Yevgeniy-Olexandrenko/avr-ay-board/hardware/README.md

PCB v1.4|PCB v1.5
:-:|:-:
|
|
New schematic and PCB design, Moved J1 closer to J2|Power LED, alternative ICSP on PSG pins
