Yevgeniy-Olexandrenko/avr-ay-board/hardware/v1.5/AY-3-8912-Emulator-v1.5_BOM.tsv

ID | Name | Designator | Footprint | Quantity | Manufacturer Part | Manufacturer | Supplier | Supplier Part
1 | 18p | C1,C3 | C0603 | 2 | CL10C180JB8NNNC | SAMSUNG | LCSC | C1647
2 | 100n | C2,C4 | C0603 | 2 | CC0603KRX7R9BB104 | YAGEO | LCSC | C14663
3 | 2.2n | C5,C6,C7 | C0603 | 3 | 0603B222K500NT | FH | LCSC | C1604
4 | 27MHz | X1 | OSC-SMD_4P-L3.2-W2.5-BL | 1 | X3S027000BA1H-U | HELE(台湾加高) | LCSC | C136079
5 | 1.4k | R4 | R0603 | 1 | CQ03WAF1401T5E | UNI-ROYAL(厚声) | LCSC | C2759756
6 | POWER | LED1 | LED0603_BLUE | 1 | FYLS-0603UBC | FORYARD
7 | ATMEGA48PA-AU | MCU | TQFP-32_L7.0-W7.0-P0.80-LS9.0-BL | 1 | ATMEGA88PA-AU | MICROCHIP(美国微芯) | LCSC | C8727
8 | 3.6k | R1,R2,R3 | R0603 | 3 | 0603WAF3601T5E | UNI-ROYAL(厚声) | LCSC | C22980
