Yevgeniy-Olexandrenko/avr-ay-board/hardware/v1.5/AY-3-8912-Emulator-v1.5_Schematic.pdf

# Headers

# Low-pass filters

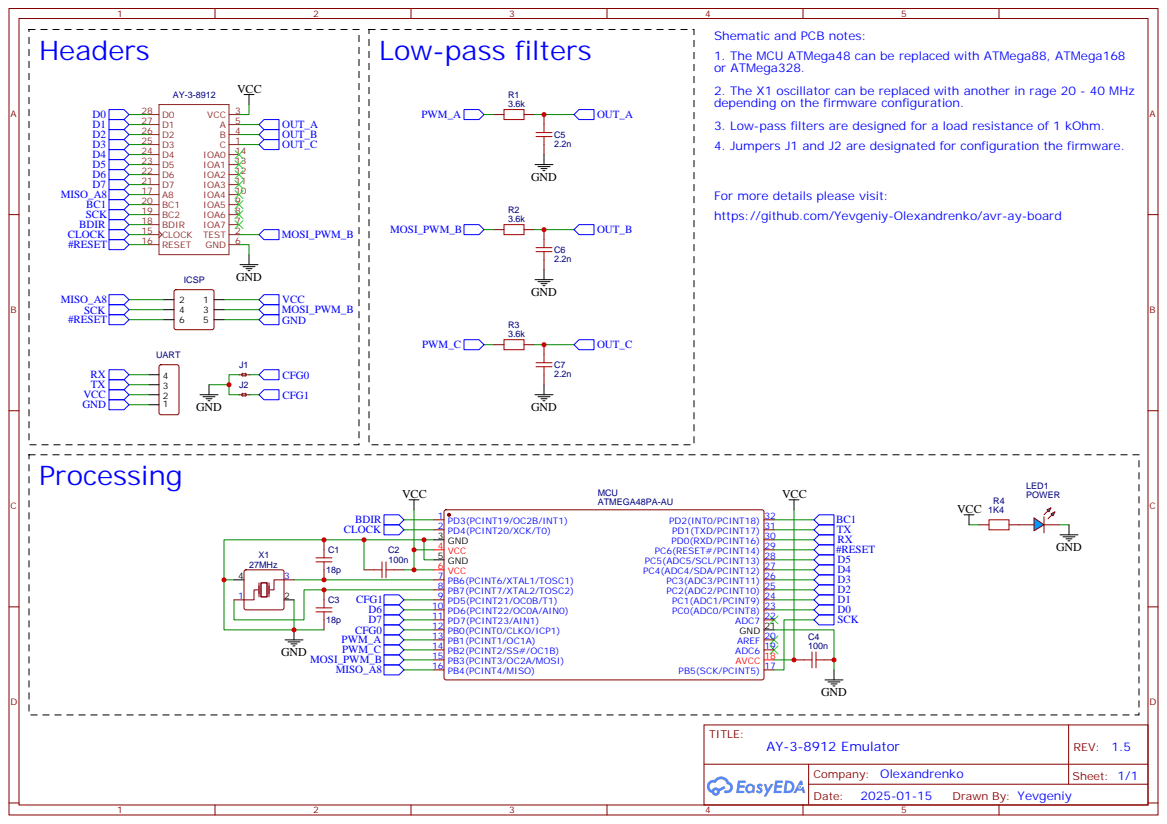
[picture p2: page 1]

Shematic and PCB notes:
1. The MCU ATMega48 can be replaced with ATMega88, ATMega168
or ATMega328.
2. The X1 oscillator can be replaced with another in rage 20 - 40 MHz
depending on the firmware configuration.
3. Low-pass filters are designed for a load resistance of 1 kOhm.
4. Jumpers J1 and J2 are designated for configuration the firmware.

For more details please visit:
https://github.com/Yevgeniy-Olexandrenko/avr-ay-board
