Yevgeniy-Olexandrenko/avr-ay-board/hardware/v1.2/AY-3-8912-Emulator-v1.2_Schematic.pdf

Processing | Low-pass filters

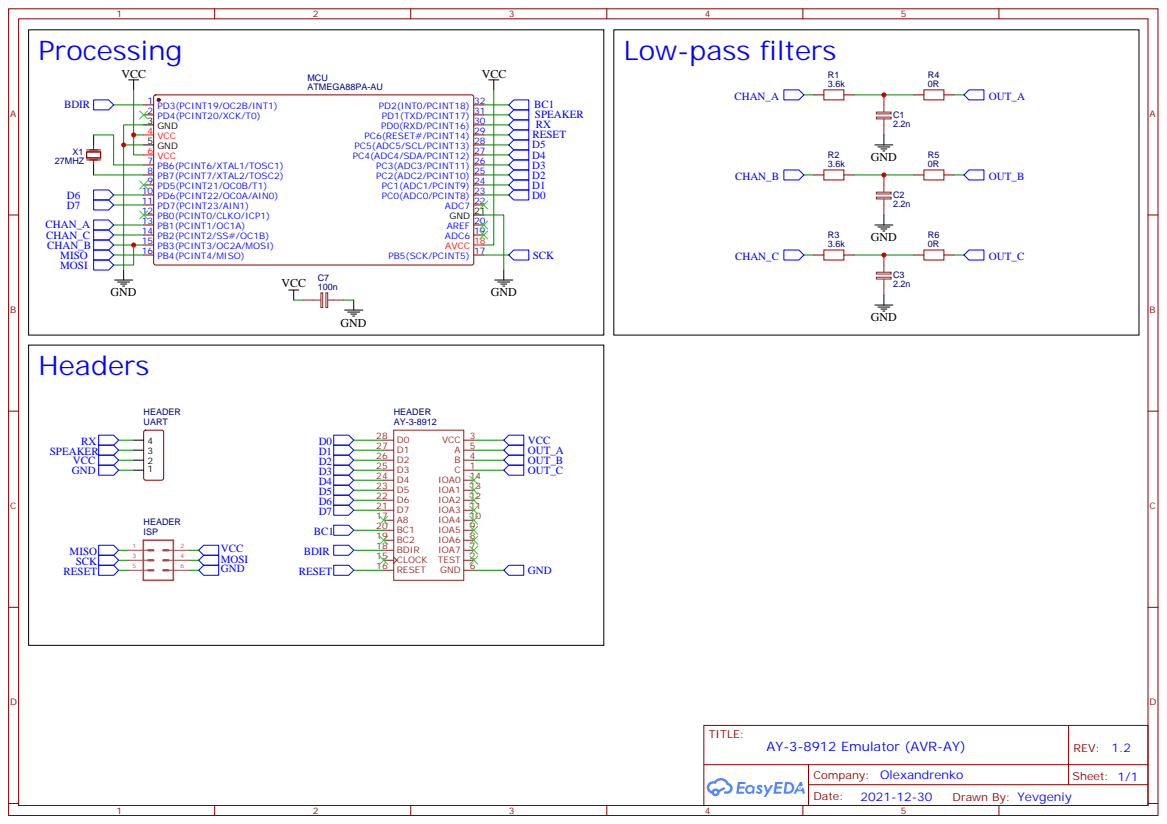
[picture p3: page 1]
