Yevgeniy-Olexandrenko/avr-ay-board/(threads)

Thread 2 (2022-01-09):

Missing informations about the differences between hardware versions V1.1 an V1.2

Taki-B, 2022-01-09:
Hi!

Thanks for publishing this project but can you add a change log, where we can see what changed from one version to the next one (and why)? As far as I can tell, the PCB hasn't changed, with the exception of the footprint of R4-R6, which replaced C4-C6 in the filter section. Both PCB should be compatible then.

Cheers,

Taki

Thread 4 (2022-05-11):

no board markings

stefi01, 2022-05-11:
Just recieved the pcb's but no R1,C1 etc printed on the board, which component goes where?

stefi01, 2022-06-23:
ok found it

Closed 2022-06-23.
