Yevgeniy-Olexandrenko/avr-ay-board/(commit log)

2020-10-28 Added BOM file
    [BOM.csv]
2021-11-16 Update project files
    [AY-3-8912-Emulator-v1.1_BOM.csv, BOM.csv]
2021-11-20 Added working arduino scetch for parallel communication test
2021-11-27 New arduino script for parallel mode with support for real AY and YM chips
2021-11-28 New: Now A & C have same amplitude as B (T1 PWM works in simple 8-bit mode)
2021-11-29 Added AY/YM volume tables calculation
    [volume_tables.ods]
2021-12-02 New: Replaced volume tables, now AY's envelope period has 16 steps
    [emulator.asm]
2021-12-11 New arduino sketches
2021-12-18 More detailed timings + shortest timings for the emulator
    [psg-access.ino]
2021-12-30 File structure reorganization
    [AY-3-8912-Emulator-v1.1_BOM.csv]
2021-12-30 Add new hardware v1.2
    [AY-3-8912-Emulator-v1.2_BOM.csv]
2022-07-06 Added new version of PCB
    [AY-3-8912-Emulator-v1.3_BOM.csv]
2022-07-06 Added new alternative firmware
    [volume_tables.ods]
2023-02-01 Update file format
    [AY-3-8912-Emulator-v1.1_BOM.tsv, AY-3-8912-Emulator-v1.2_BOM.tsv, AY-3-8912-Emulator-v1.3_BOM.tsv]
2023-02-06 Adde v1.4 + cleanup
    [AY-3-8912-Emulator-v1.1_BOM.tsv, AY-3-8912-Emulator-v1.4_BOM.tsv]
2025-01-15 Added new version of the PCB
    [AY-3-8912-Emulator-v1.5_BOM.tsv, AY-3-8912-Emulator-v1.5_PickAndPlace.csv]
2026-02-01 Cleanup repository
    [volume_tables.ods]
2026-02-01 Add PCB v1.5 details to README
2026-02-01 Update README.md
    Updated the hardware README to reflect changes in PCB v1.5.
